jaimebuildsthings/pit-pyro/hardware/README.md

# Hardware

Mechanical design and printable parts.

- [`enclosure/`](enclosure/): phase 2 pistol-grip enclosure (OpenSCAD source, STLs, renders)
- [`sensor-carrier/`](sensor-carrier/): 20 × 20 mm PCB for the bare MLX90640 (KiCad, generated by a script; Gerbers ready to order)

Hardware designs in this folder are licensed under [CERN-OHL-P-2.0](LICENSE).
