jaimebuildsthings/pit-pyro/hardware/enclosure/stl/test-trigger.stl

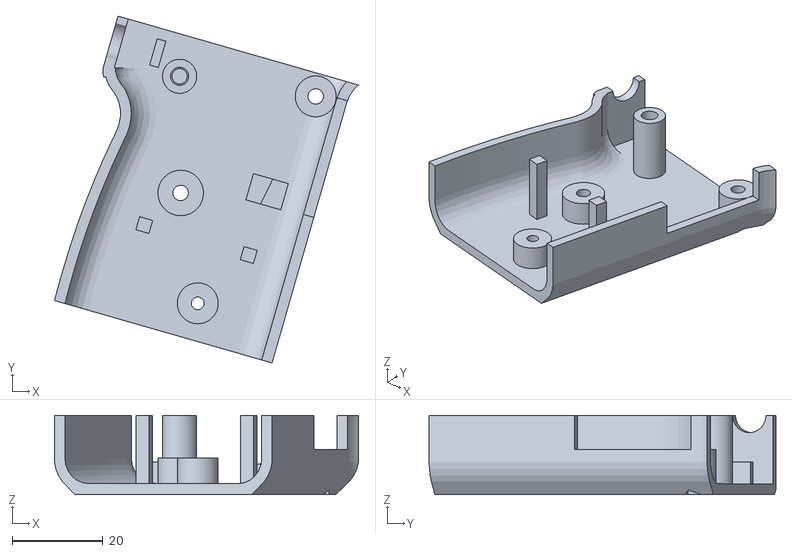
[picture p7: CAD file, 2026-11-13]
hardware/enclosure/stl/test-trigger.stl
66.9 x 76.3 x 17.5
