jaimebuildsthings/pit-pyro/hardware/enclosure/stl/enclosure-left.stl

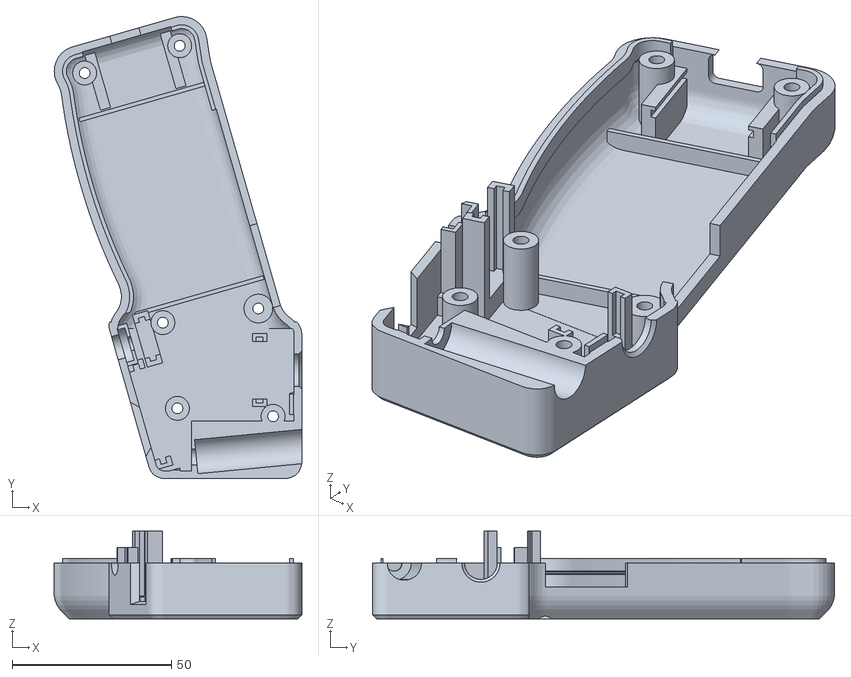
[picture p8: CAD file, 2026-11-13]
hardware/enclosure/stl/enclosure-left.stl
77.6 x 144.9 x 27.5
