jaimebuildsthings/pit-pyro/hardware/enclosure/stl/button-cap.stl

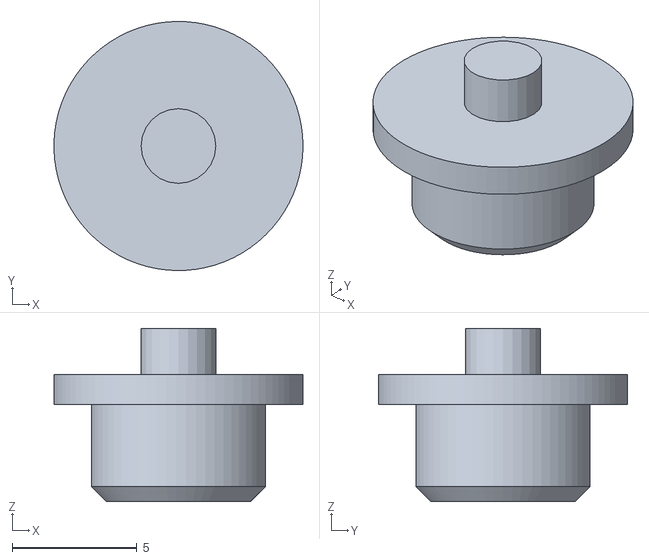
[picture p9: CAD file, 2026-11-13]
hardware/enclosure/stl/button-cap.stl
10.00 x 10.00 x 6.95
