jaimebuildsthings/pit-pyro/hardware/enclosure/stl/enclosure-right.stl

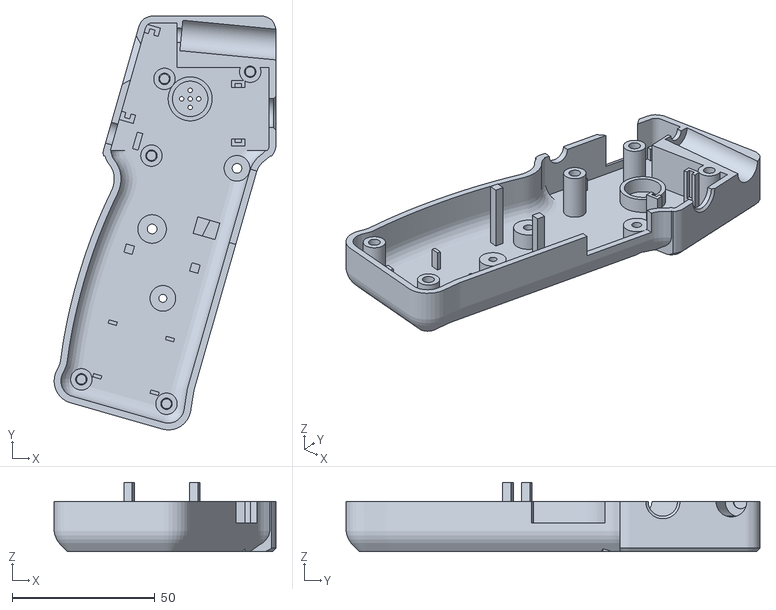
[picture p10: CAD file, 2026-11-13]
hardware/enclosure/stl/enclosure-right.stl
77.6 x 144.9 x 24.1
