jaimebuildsthings/pit-pyro/hardware/enclosure/stl/test-button.stl

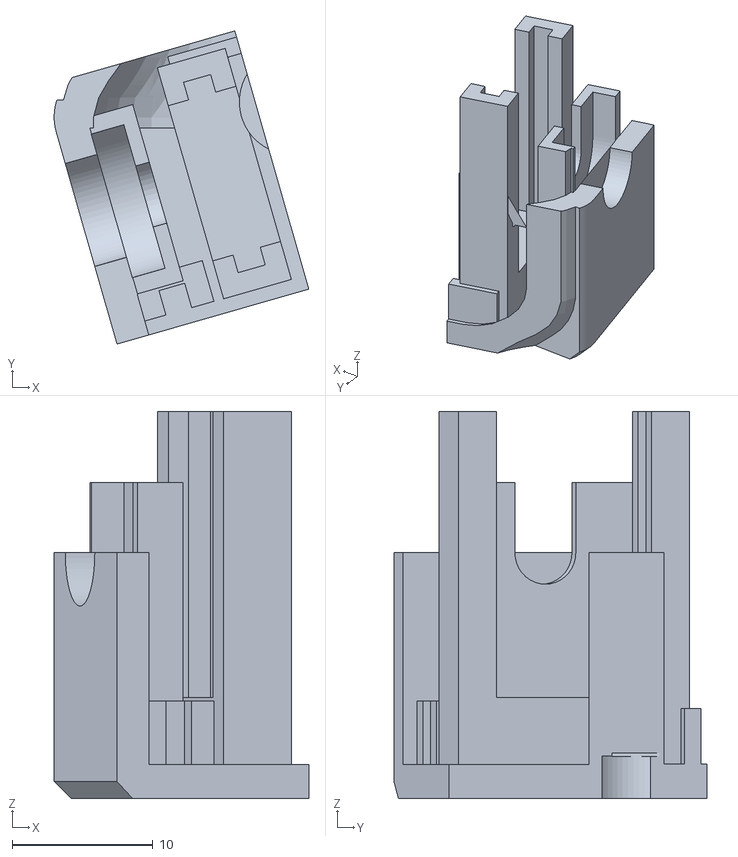
[picture p11: CAD file, 2026-11-13]
hardware/enclosure/stl/test-button.stl
18.1 x 22.2 x 27.5
