jaimebuildsthings/pit-pyro/hardware/enclosure/stl/trigger.stl

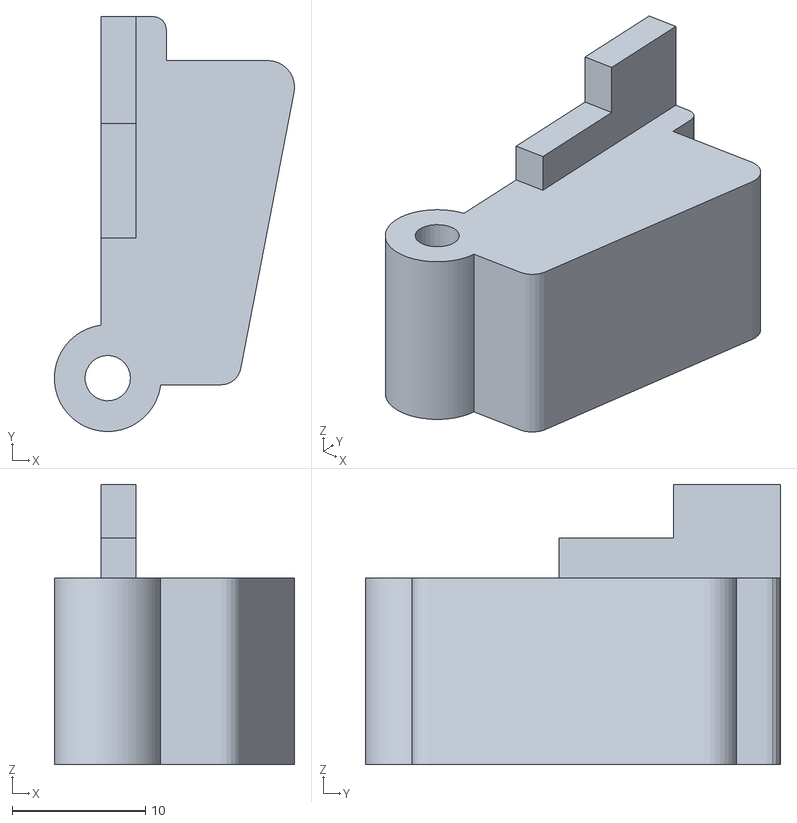
[picture p12: CAD file, 2026-10-23]
hardware/enclosure/stl/trigger.stl
18.0 x 31.1 x 21.0
