jaimebuildsthings/pit-pyro/(commit log)

2026-10-15 docs: initial plan for a handheld tire temperature scanner
2026-10-15 docs: plan for store-on-device scanning at autocross
    Readings are stored with run numbers and synced to stringline later
    (USB/Web Serial first, then Bluetooth). Adds a small screen so nothing
    at the car needs a phone, an optional DS3231 clock, a flash run log,
    and a syncing section that weighs an iPhone app against Web
    Serial/Web Bluetooth.
2026-10-15 docs: expose the ESP32's USB-C for flashing
2026-10-16 docs: add the parts list; FeatherS3[D], deep sleep, track days
    The parts list (bom.md) has the ordered part numbers and buying notes.
    The plan moves to the FeatherS3[D] (one USB-C, built-in LiPo charger),
    drops the Pololu switch for deep sleep, and covers track days too.
2026-10-16 hardware: printable pistol-grip enclosure
    Parametric OpenSCAD model in two halves that print flat without supports,
    with a hinged paddle trigger, a USB cover, STLs, renders and a fit check.
    Sized for the ordered parts; measure them and re-export before printing.
    Licensed CERN-OHL-P-2.0.
    [enclosure-left.stl, enclosure-right.stl, enclosure.scad, trigger.stl, usb-cover.stl]
2026-10-16 chore: scaffold repository: README, licenses, contributing, CI
    Same layout as corner-balancer: Apache-2.0 for code, CC-BY-SA-4.0 for
    docs, CERN-OHL-P-2.0 for hardware; Contributor Covenant; editor config;
    CODEOWNERS, a TruffleHog secrets scan and Dependabot for Actions. The
    contributing guide covers the enclosure workflow; no code CI yet.
2026-10-17 hardware: enclosure v0.3 with a menu button, short tall head, screen facing you (#1)
    * hardware: add a menu button to the enclosure
    A 6 mm tactile button on the rear face, above the USB port, behind a
    printed cap. It opens and steps through the menu; the trigger selects.
    The plan gains the menu (view, delete last reading, clear, settings,
    sync, info), the BOM the Adafruit 367 button.
    * hardware: enclosure v0.3, short tall head with the screen facing you
    The Feather moves into the grip, between the battery and the clock,
    with its USB-C through the butt. That frees the head: 61 x 49 mm
    (was 82 x 40), with the screen and menu button on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
    [button-cap.stl, enclosure-left.stl, enclosure-right.stl, enclosure.scad, usb-cover.stl]
2026-10-23 hardware: enclosure v0.4, sized to the measured parts (#2)
    * hardware: enclosure v0.4, sized to the measured parts
    Every part measured with calipers. The model is updated: the
    standard-size switch on two posts with a steel pin, a narrower centred
    trigger with a pad under the roller and a stop ear, the clock across the
    grip, the longer laser, the sensor seated flush, the OLED in four corner
    slots. Adds test-trigger and test-laser test prints, and documents the
    measured sizes, wiring (COM + NO, 200 mm screen cable) and assembly.
    Claude-Session: https://claude.ai/code/session_0136MWC3yYUadJW3nXvzavt3
    * hardware: drop the laser test prin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
    [enclosure-left.stl, enclosure-right.stl, enclosure.scad, test-trigger.stl, trigger.stl]
2026-10-24 firmware: desk test, the MLX90640's image in °C (#4)
    * firmware: read the MLX90640 and print its image in °C
    A no_std driver and Melexis's temperature maths, ported from their
    Apache-2.0 reference driver, plus a first ESP32-S3 program with a serial
    console on the Feather's USB-C. The port matches Melexis's own C code
    within 0.0001 °C on a dump from the desk-test sensor; that dump is now a
    test fixture. CI checks the host crates and builds the firmware.
    * docs: desk test guide, live thermal viewer, room behind the sensor
    tools/viewer.html shows the sensor's im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
    [desk-dump.txt, desk-melexis.csv]
2026-10-24 hardware: drop the USB cover, leave the port open (#5)
    * hardware: drop the USB cover, leave the port open
    The cover was a loose push-in plug, easy to lose. The USB-C port
    handles dust well enough, and the butt looks cleaner without it.
    * hardware: re-render the cutaway and rear without the USB cover
    ---------
    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
    [enclosure.scad, usb-cover.stl]
2026-10-24 hardware: sensor carrier PCB for the bare MLX90640 (#6)
    A 20 × 20 mm two-layer board that fits the enclosure's carrier rails:
    holes on the sensor's real pin layout (two pairs on a Ø5.84 mm circle,
    datasheet Figure 27), the pull-ups and supply capacitors on the back,
    and four labelled cable holes. Generated by generate.py with KiCad's
    Python; DRC clean apart from the two custom footprints not being in a
    library. Gerbers are zipped in fab/. The docs point to it instead of
    perfboard.
    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
    [sensor-carrier.kicad_pcb]
2026-10-24 docs: supply capacitors fix the stripes; viewer run timer (#7)
    The desk test's every-fourth-column stripes (+0.7–1.2 °C) came from a
    sensor wired without its supply capacitors. A third sensor with 100 nF +
    10 µF across VDD/GND, held by the board and warmed up for 4 minutes,
    reads within ±0.1 °C. The guide now has the capacitors, pad cleaning and
    the warm-up; the viewer shows a run timer that says "settling" for the
    first 4 minutes.
    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
2026-10-28 ci: pin espup 0.17.1; 0.18.0 was withdrawn (#9)
    The v0.18.0 release is gone from esp-rs/espup, so the firmware job's
    download 404s on every run. 0.17.1 installs the same 1.97.0.0 toolchain
    (corner-scales' CI uses that pair).
    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
2026-10-28 hardware: room behind the inserts for a screw that's too long (#8)
    A screw longer than the insert pocket bottomed out and split a post on
    the first print. Each insert hole in the right half now carries on as a
    3.4 mm clearance hole down the post to the outer wall, about 7 mm more;
    the outer wall stays closed.
    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
    [enclosure-right.stl, enclosure.scad]
2026-11-13 firmware: show the thermal image and its readings on the OLED (#12)
    A new host-tested crate, crates/screen, draws what the 128 x 64 OLED
    shows: the 32 x 24 image as a 64 x 48 ordered-dither heat map, the
    hottest, mean and coldest temperatures beside it in a 3 x 5 font at
    twice size, and a 1-pixel frame around the panel's edge to measure the
    lit area against the case's window. Frames come out in the SSD1306's
    page layout.
    pyro/src/oled.rs is a small SSD1306 driver on STEMMA QT port 1 (0x3D or
    0x3C, Adafruit's start-up sequence, one page per I2C write). The app
    looks for the panel at start-up and every 2 s while it's missing, shows
    each new image, blanks to the frame when the sensor is lost,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
    [app.rs, lib.rs, main.rs, oled.rs]
2026-11-13 docs: camera view in the menu (#13)
    The live thermal view on the OLED becomes a menu item, for showing
    people what the sensor sees. It stays on until either button is pressed,
    so the menu's 5 s timeout doesn't cut it short.
2026-11-13 hardware: first test-fit revision (laser leads, menu button) (#11)
    * hardware: channel for the laser's leads behind its bore
    The laser bore stopped 1.4 mm short of the back of its block, so the
    two leads coming straight out of the laser's back end had nowhere to go.
    A 5 mm channel on the laser's axis now runs through the back of the
    block into the space behind the OLED.
    * hardware: menu button holder and cap for the measured button
    Re-measured over the four raised rivets on its metal plate, the button
    is 3.6 mm deep (not 2.7) and its plunger stands only 0.45 mm above them
    (not 1.5). The slot was too short for the body, which snapped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
    [button-cap.stl, enclosure-left.stl, enclosure-right.stl, enclosure.scad, test-button.stl, test-trigger.stl]
